lfs676/AC-Peltier/data/Placa Final.png

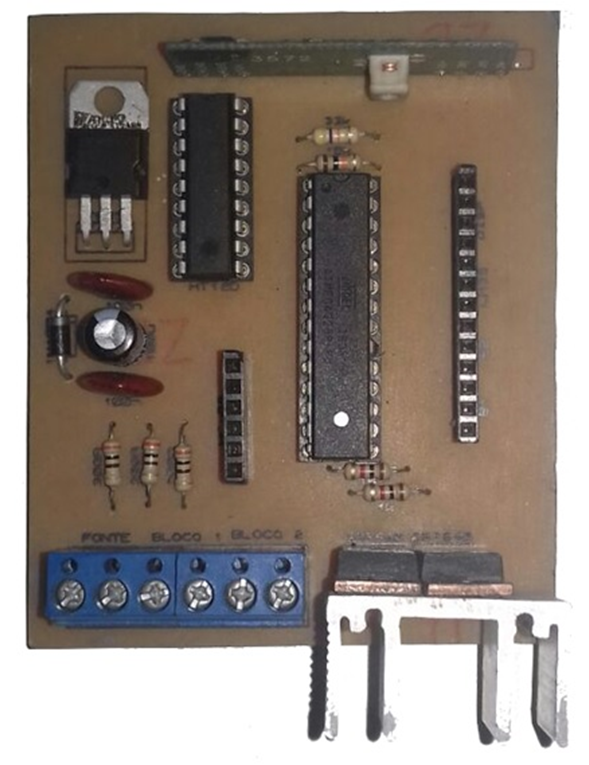
data/Placa Final.png
