lfs676/AC-Peltier/AC Peltier Layout.PDF

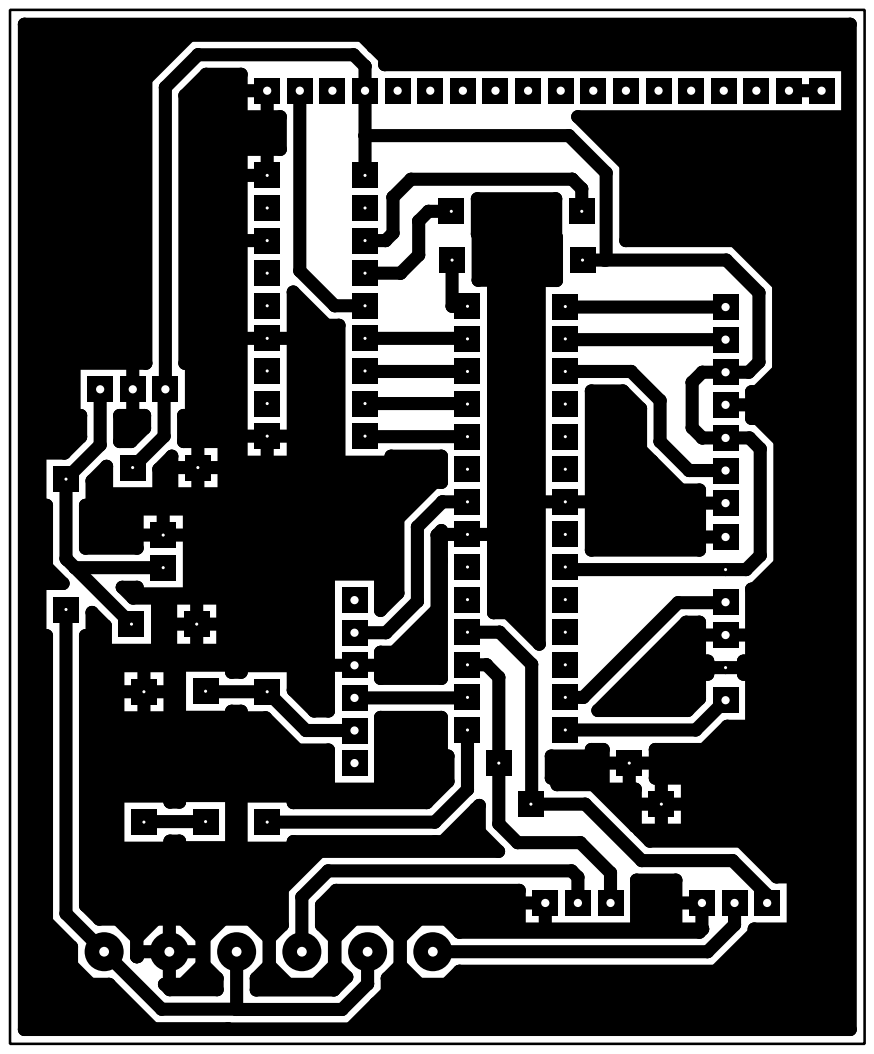
[picture p7: page 1]
