lfs676/AC-Peltier/RF Controller Layout.PDF

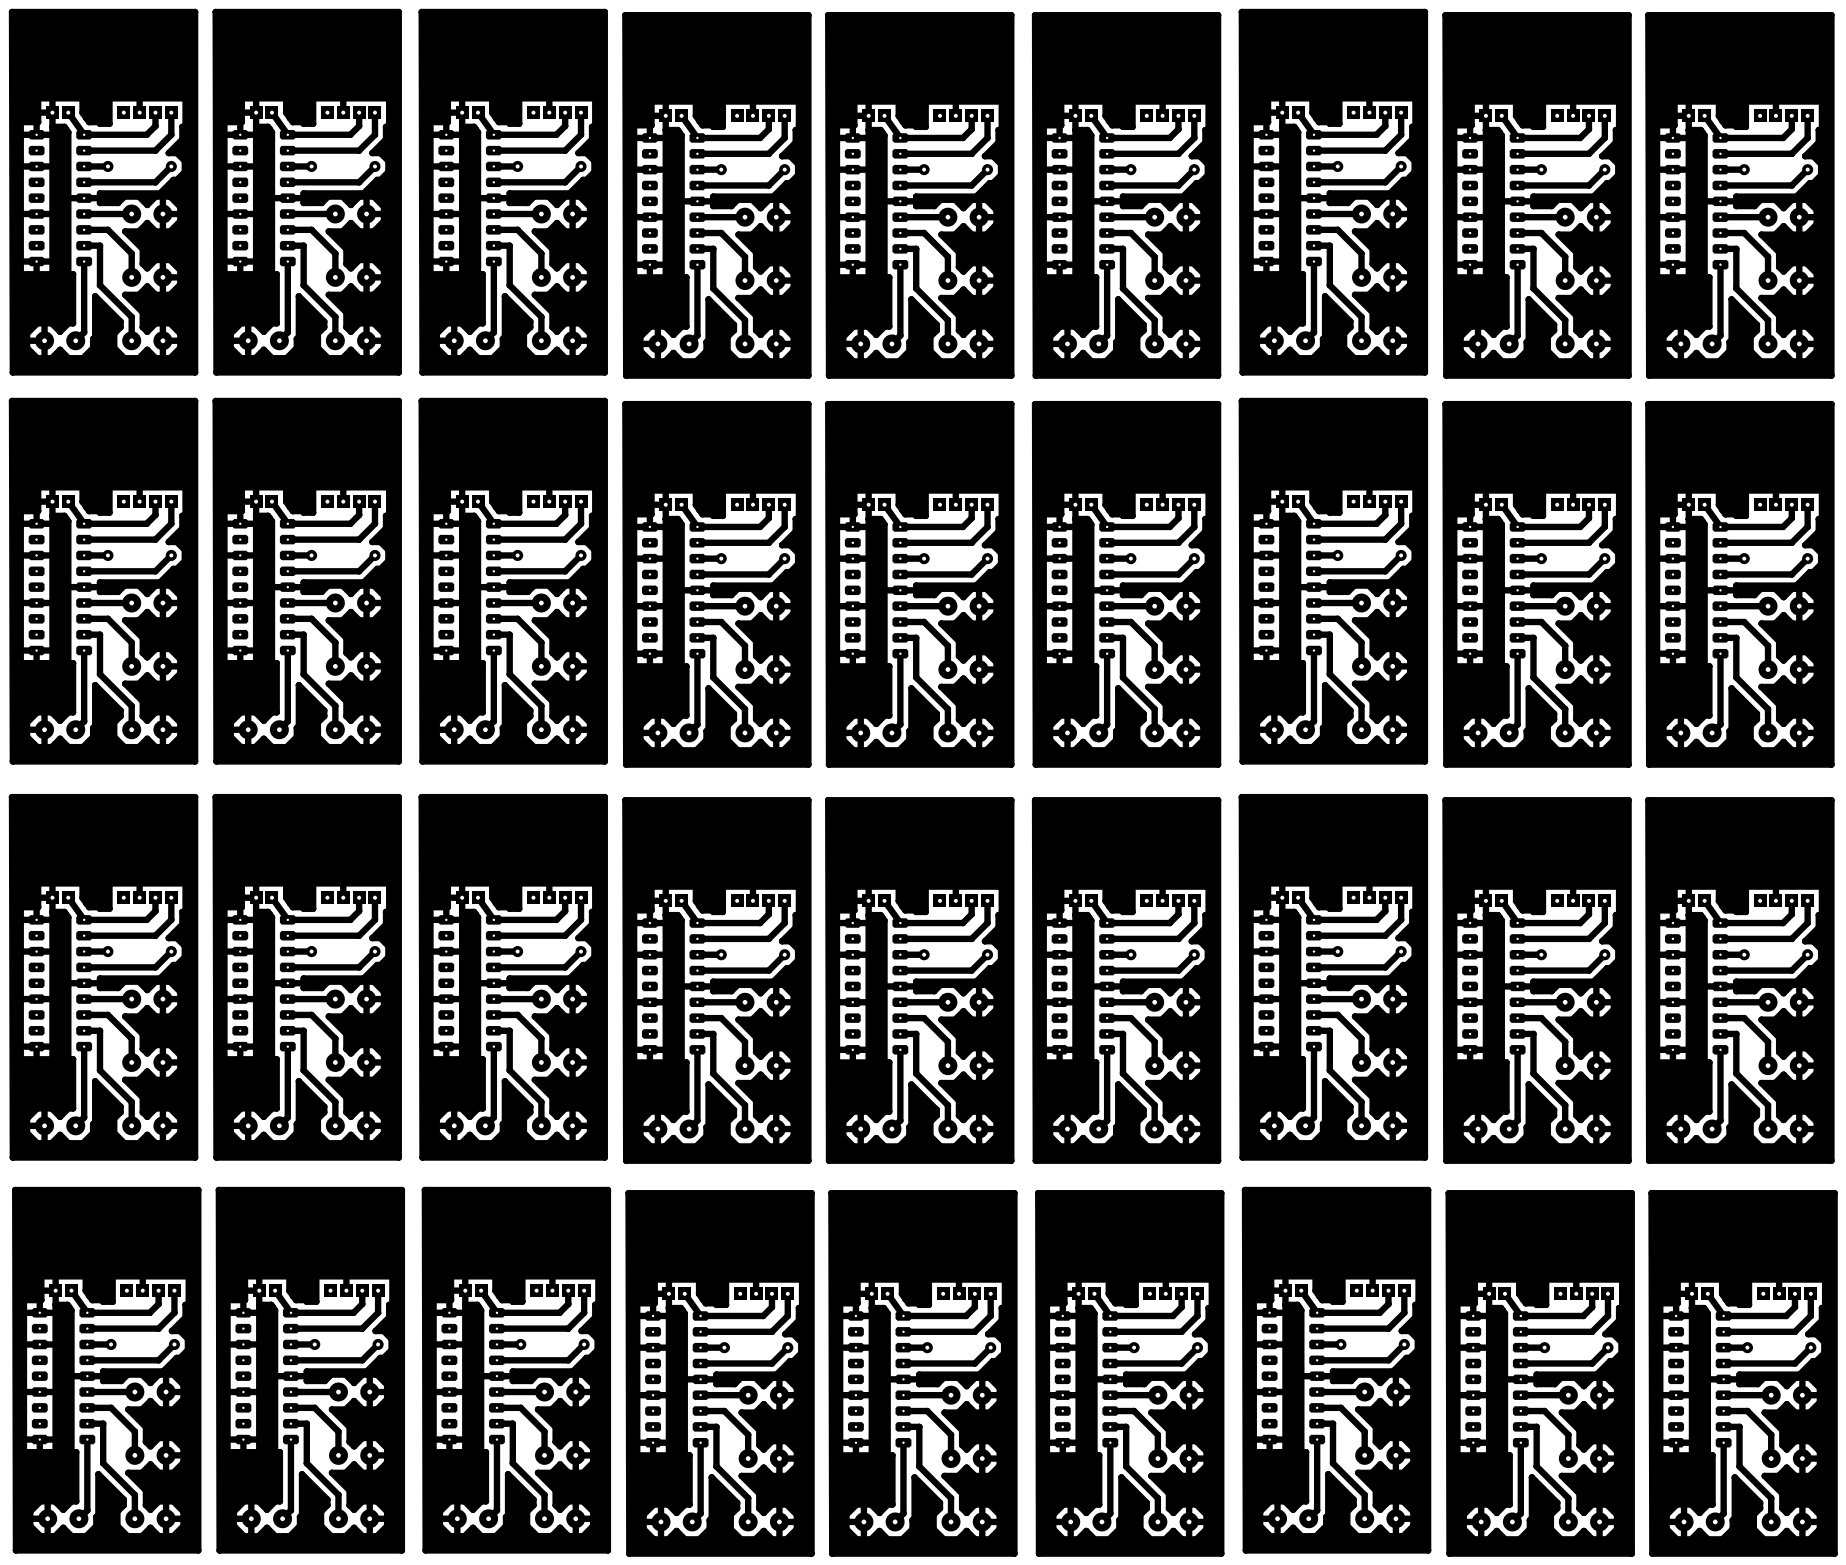
[picture p8: page 1]
