lfs676/AC-Peltier/(list of files, drawings)

Other design files:
AC Peltier.pdsprj
RF Controller.pdsprj
